ppendyala1/esp32-offline-vault/hardware/PARTS.md

# Parts List

| Qty | Part |
| --- | --- |
| 1 | [Adafruit Feather ESP32-S3, 4 MB flash / 2 MB PSRAM](https://www.adafruit.com/product/5477) — includes LiPo charging |
| 1 | [ST7789 1.14-inch SPI TFT display, 240 × 135](https://www.adafruit.com/product/4383) |
| 1 | [DS3231 RTC breakout](https://www.adafruit.com/product/3013) |
| 1 | CR1220 coin cell for RTC backup |
| 1 | [3.7 V, 1200 mAh LiPo battery](https://www.adafruit.com/product/258) |
| 4 | [Momentary push buttons](https://www.adafruit.com/product/1119) — Up, Down, OK, Back |
| 1 | [Slide switch](https://www.adafruit.com/product/805) |
| 1 | USB-C data cable |
| 1 | Breadboard and jumper-wire set |
| 1 | Perfboard, headers, and hookup wire |
| 1 | Enclosure with mounting screws and standoffs |

# Build Steps

1. Program and test the ESP32 over USB.
2. Connect and test the display.
3. Connect the RTC, install its coin cell, and set UTC time.
4. Connect and test the four buttons.
5. Add the LiPo and power switch; test battery operation.
6. Solder the final wiring and mount everything in the enclosure.
