ppendyala1/esp32-offline-vault/hardware/enclosure/step/enclosure_assembly.step

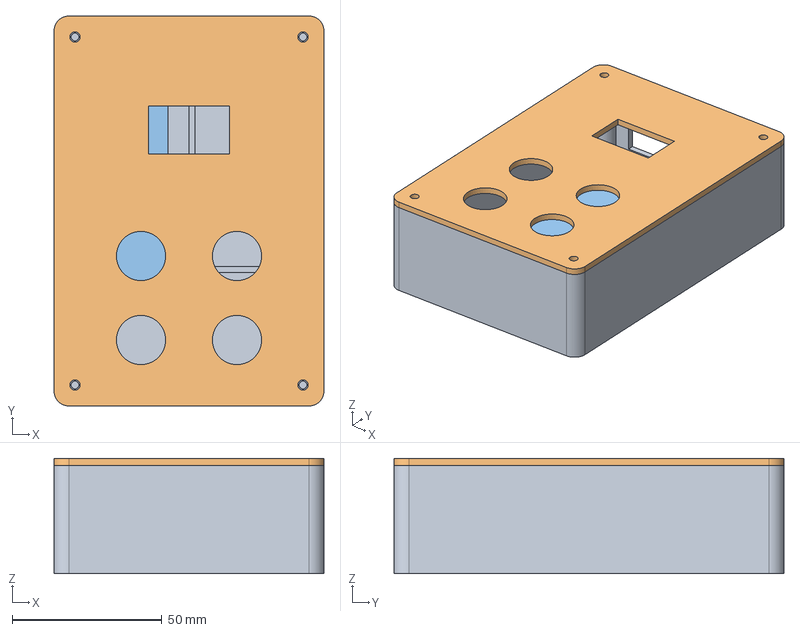
[picture p4: CAD file, 2026-10-29]
hardware/enclosure/step/enclosure_assembly.step
90.0 x 130.0 x 38.4 mm
base
lid
electronics_tray
