ppendyala1/esp32-offline-vault/hardware/enclosure/step/base.step

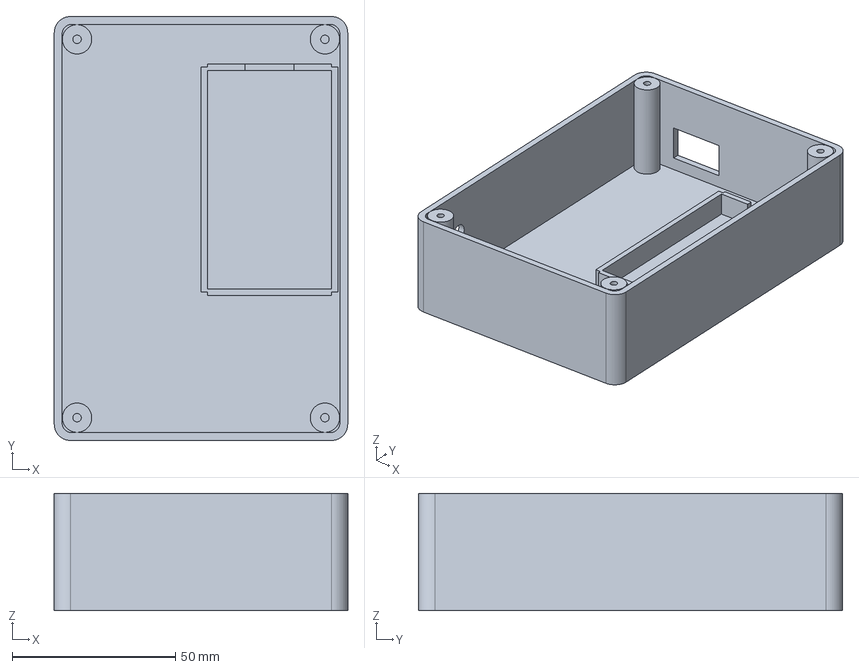
[picture p5: CAD file, 2026-10-29]
hardware/enclosure/step/base.step
90.0 x 130.0 x 36.0 mm
