ppendyala1/esp32-offline-vault/hardware/enclosure/step/electronics_tray.step

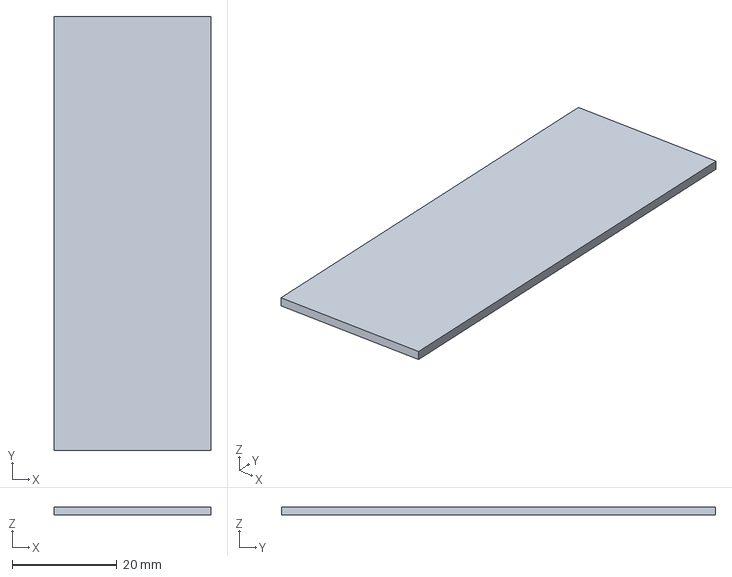
[picture p6: CAD file, 2026-10-29]
hardware/enclosure/step/electronics_tray.step
30.0 x 83.0 x 1.60 mm
