ppendyala1/esp32-offline-vault/hardware/enclosure/step/lid.step

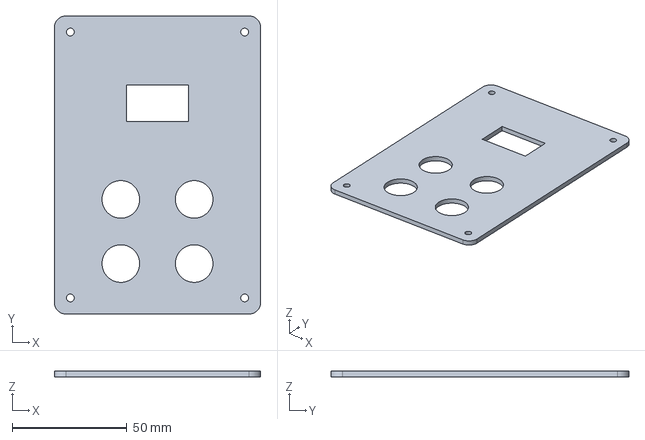
[picture p7: CAD file, 2026-10-29]
hardware/enclosure/step/lid.step
90.0 x 130.0 x 2.40 mm
