ppendyala1/esp32-offline-vault/(list of files, cad)

Other CAD files:
hardware/enclosure/stl/base.stl
hardware/enclosure/stl/electronics_tray.stl
hardware/enclosure/stl/lid.stl
