ppendyala1/esp32-offline-vault/(commit log)

2026-10-03 csv file for partitions
    [partitions.csv]
2026-10-03 switching from platformio to ESP-IDF
2026-10-25 Integrate offline vault firmware and device controls
    Integrate display screens, debounced navigation, local unlock, timed password reveal, RTC TOTP, and USB session locking. Group firmware modules by responsibility and retain optional target crypto self-tests. Verified with the ESP-IDF 6.1 build; hardware qualification remains outstanding.
2026-10-29 Add provisioning tools and host verification
    Add non-echoing USB provisioning for initialization, account entry, and UTC clock updates. Exercise vault storage, session deadlines, button input, TOTP vectors, RTC recovery, display buffer clearing, and provisioning protocol behavior with host-side simulations. All 25 software tests pass; physical hardware validation remains outstanding.
2026-10-29 Document device setup, wiring, and verification
    Describe ESP-IDF build and flash steps, USB provisioning commands, board pin assignments, and power wiring. Record software verification results and the remaining physical board acceptance procedure, and organize the parts list under hardware.
2026-10-29 Add enclosure prototype models and geometry previews
    [base.step, base.stl, electronics_tray.step, electronics_tray.stl, enclosure_assembly.step, lid.step, lid.stl]
